RajmohanSriram/Nano-PPS/PPS_Trigger_mod.csv

Reference | Qty | Value | DNP | Exclude from BOM | Exclude from Board | Exclude from Simulation | Exclude from Position Files | Footprint | Datasheet
C1 | 1 | 100n |  |  |  |  | ${EXCLUDE_FROM_POS_FILES} | Capacitor_SMD:C_0805_2012Metric_Pad1.18x1.45mm_HandSolder
C2,C7,C17,C25 | 4 | 10u |  |  |  |  | ${EXCLUDE_FROM_POS_FILES} | Capacitor_SMD:C_0805_2012Metric_Pad1.18x1.45mm_HandSolder
C3 | 1 | 1u |  |  |  |  | ${EXCLUDE_FROM_POS_FILES} | Capacitor_SMD:C_0805_2012Metric_Pad1.18x1.45mm_HandSolder
C4,C6,C8,C11,C14,C15,C16,C18,C19,C20,C21,C22,C23,C24,C26,C27,C28 | 17 | 100n |  |  |  |  | ${EXCLUDE_FROM_POS_FILES} | Capacitor_SMD:C_0603_1608Metric_Pad1.08x0.95mm_HandSolder
C5 | 1 | 1u |  |  |  |  | ${EXCLUDE_FROM_POS_FILES} | Capacitor_SMD:C_0603_1608Metric_Pad1.08x0.95mm_HandSolder
C9,C10 | 2 | 22u |  |  |  |  | ${EXCLUDE_FROM_POS_FILES} | Capacitor_SMD:C_1210_3225Metric_Pad1.33x2.70mm_HandSolder
C12,C13 | 2 | 22p |  |  |  |  | ${EXCLUDE_FROM_POS_FILES} | Capacitor_SMD:C_0603_1608Metric_Pad1.08x0.95mm_HandSolder
D1,D2 | 2 | SMBJ24CA |  |  |  |  | ${EXCLUDE_FROM_POS_FILES} | SMBJ24CA:DIOM4336X265N
D3,D4 | 2 | LED |  |  |  |  | ${EXCLUDE_FROM_POS_FILES} | LED_SMD:LED_0603_1608Metric_Pad1.05x0.95mm_HandSolder
J1,J3 | 2 | Screw_Terminal_01x02 |  |  |  |  | ${EXCLUDE_FROM_POS_FILES} | TerminalBlock:TerminalBlock_MaiXu_MX126-5.0-02P_1x02_P5.00mm
J2 | 1 | USB4105-GF-A-120 |  |  |  |  | ${EXCLUDE_FROM_POS_FILES} | USB4105-GF-A-120:GCT_USB4105-GF-A-120
J4 | 1 | I2C_OLED |  |  |  |  | ${EXCLUDE_FROM_POS_FILES} | Connector_PinHeader_2.54mm:PinHeader_1x04_P2.54mm_Vertical
J5 | 1 | ICSP |  |  |  |  | ${EXCLUDE_FROM_POS_FILES} | Connector_PinSocket_2.54mm:PinSocket_2x03_P2.54mm_Vertical
L1 | 1 | 4u7 |  |  |  |  | ${EXCLUDE_FROM_POS_FILES} | Inductor_SMD:L_APV_ANR6045
Q1 | 1 | AO3400A |  |  |  |  | ${EXCLUDE_FROM_POS_FILES} | Package_TO_SOT_SMD:SOT-23 | http://www.aosmd.com/pdfs/datasheet/AO3400A.pdf
R1 | 1 | 5m |  |  |  |  | ${EXCLUDE_FROM_POS_FILES} | Resistor_SMD:R_0603_1608Metric_Pad0.98x0.95mm_HandSolder
R2 | 1 | 6.2K |  |  |  |  | ${EXCLUDE_FROM_POS_FILES} | Resistor_SMD:R_0603_1608Metric_Pad0.98x0.95mm_HandSolder
R3,R4 | 2 | 5.1K |  |  |  |  | ${EXCLUDE_FROM_POS_FILES} | Resistor_SMD:R_0603_1608Metric_Pad0.98x0.95mm_HandSolder
R5,R8 | 2 | 10K |  |  |  |  | ${EXCLUDE_FROM_POS_FILES} | Resistor_SMD:R_0603_1608Metric_Pad0.98x0.95mm_HandSolder
R6,R7 | 2 | 4.7K |  |  |  |  | ${EXCLUDE_FROM_POS_FILES} | Resistor_SMD:R_0603_1608Metric_Pad0.98x0.95mm_HandSolder
R9,R10 | 2 | 1K |  |  |  |  | ${EXCLUDE_FROM_POS_FILES} | Resistor_SMD:R_0603_1608Metric_Pad0.98x0.95mm_HandSolder
SW1 | 1 | V_DEC |  |  |  |  | ${EXCLUDE_FROM_POS_FILES} | Button_Switch_THT:SW_PUSH_6mm_H5mm
SW2 | 1 | I_DEC |  |  |  |  | ${EXCLUDE_FROM_POS_FILES} | Button_Switch_THT:SW_PUSH_6mm_H5mm
SW3 | 1 | OUTPUT_CTRL |  |  |  |  | ${EXCLUDE_FROM_POS_FILES} | Button_Switch_THT:SW_PUSH_6mm_H5mm
SW4 | 1 | V_INC |  |  |  |  | ${EXCLUDE_FROM_POS_FILES} | Button_Switch_THT:SW_PUSH_6mm_H5mm
SW5 | 1 | I_INC |  |  |  |  | ${EXCLUDE_FROM_POS_FILES} | Button_Switch_THT:SW_PUSH_6mm_H5mm
SW6 | 1 | MCU_~{RST} |  |  |  |  | ${EXCLUDE_FROM_POS_FILES} | Button_Switch_THT:SW_PUSH_6mm_H5mm
TH1 | 1 | Thermistor_NTC |  |  |  |  | ${EXCLUDE_FROM_POS_FILES} | Resistor_THT:R_Axial_DIN0204_L3.6mm_D1.6mm_P7.62mm_Horizontal
TP1,TP2,TP3,TP4,TP5,TP6,TP7,TP8,TP9,TP10,TP11 | 11 | TestPoint |  |  |  |  | ${EXCLUDE_FROM_POS_FILES} | TestPoint:TestPoint_Pad_D1.0mm
U1 | 1 | USBLC6-2SC6 |  |  |  |  | ${EXCLUDE_FROM_POS_FILES} | Package_TO_SOT_SMD:SOT-23-6 | https://www.st.com/resource/en/datasheet/usblc6-2.pdf
U2 | 1 | AP33772SDKZ-xx-FA02 |  |  |  |  | ${EXCLUDE_FROM_POS_FILES} | Package_DFN_QFN:Texas_RTW_WQFN-24-1EP_4x4mm_P0.5mm_EP2.7x2.7mm | https://www.diodes.com/datasheet/download/AP33772S.pdf
U3 | 1 | AP63205WU |  |  |  |  | ${EXCLUDE_FROM_POS_FILES} | Package_TO_SOT_SMD:TSOT-23-6 | https://www.diodes.com/assets/Datasheets/AP63200-AP63201-AP63203-AP63205.pdf
U4 | 1 | CH340C |  |  |  |  | ${EXCLUDE_FROM_POS_FILES} | Package_SO:SOIC-16_3.9x9.9mm_P1.27mm | https://datasheet.lcsc.com/szlcsc/Jiangsu-Qin-Heng-CH340C_C84681.pdf
U5 | 1 | ATmega328P-A |  |  |  |  | ${EXCLUDE_FROM_POS_FILES} | Package_QFP:TQFP-32_7x7mm_P0.8mm | http://ww1.microchip.com/downloads/en/DeviceDoc/ATmega328_P%20AVR%20MCU%20with%20picoPower%20Technology%20Data%20Sheet%2040001984A.pdf
Y1 | 1 | 16MHz |  |  |  |  | ${EXCLUDE_FROM_POS_FILES} | Crystal:Crystal_SMD_HC49-SD
