RajmohanSriram/Nano-PPS/FIN_SCHE.pdf

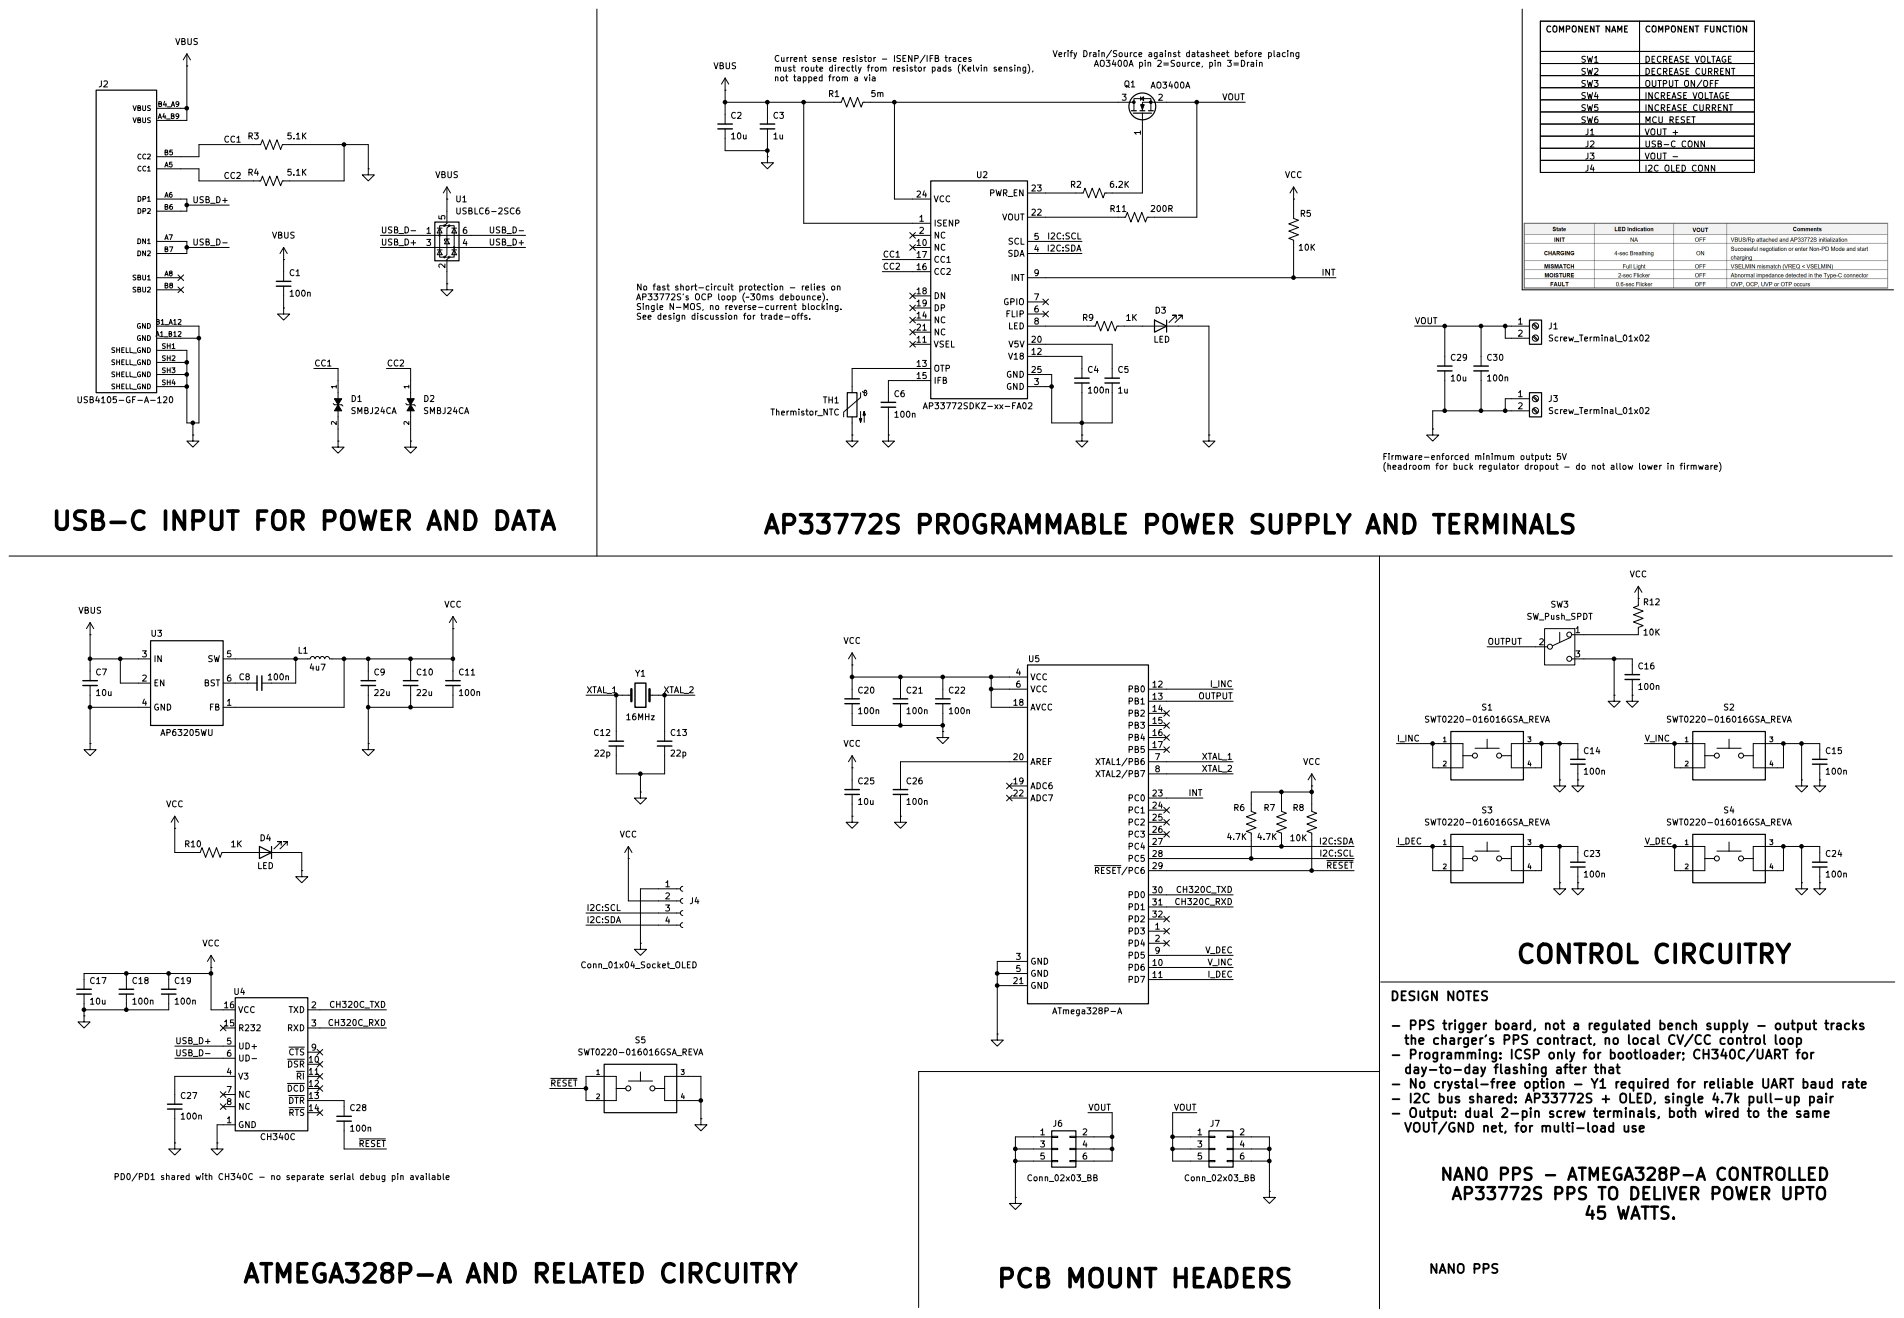
[picture p10: page 1]
