RajmohanSriram/Nano-PPS/PPS_Trigger_mod.kicad_pcb

## KiCad design PPS_Trigger_mod.kicad_pcb (2026-10-08)

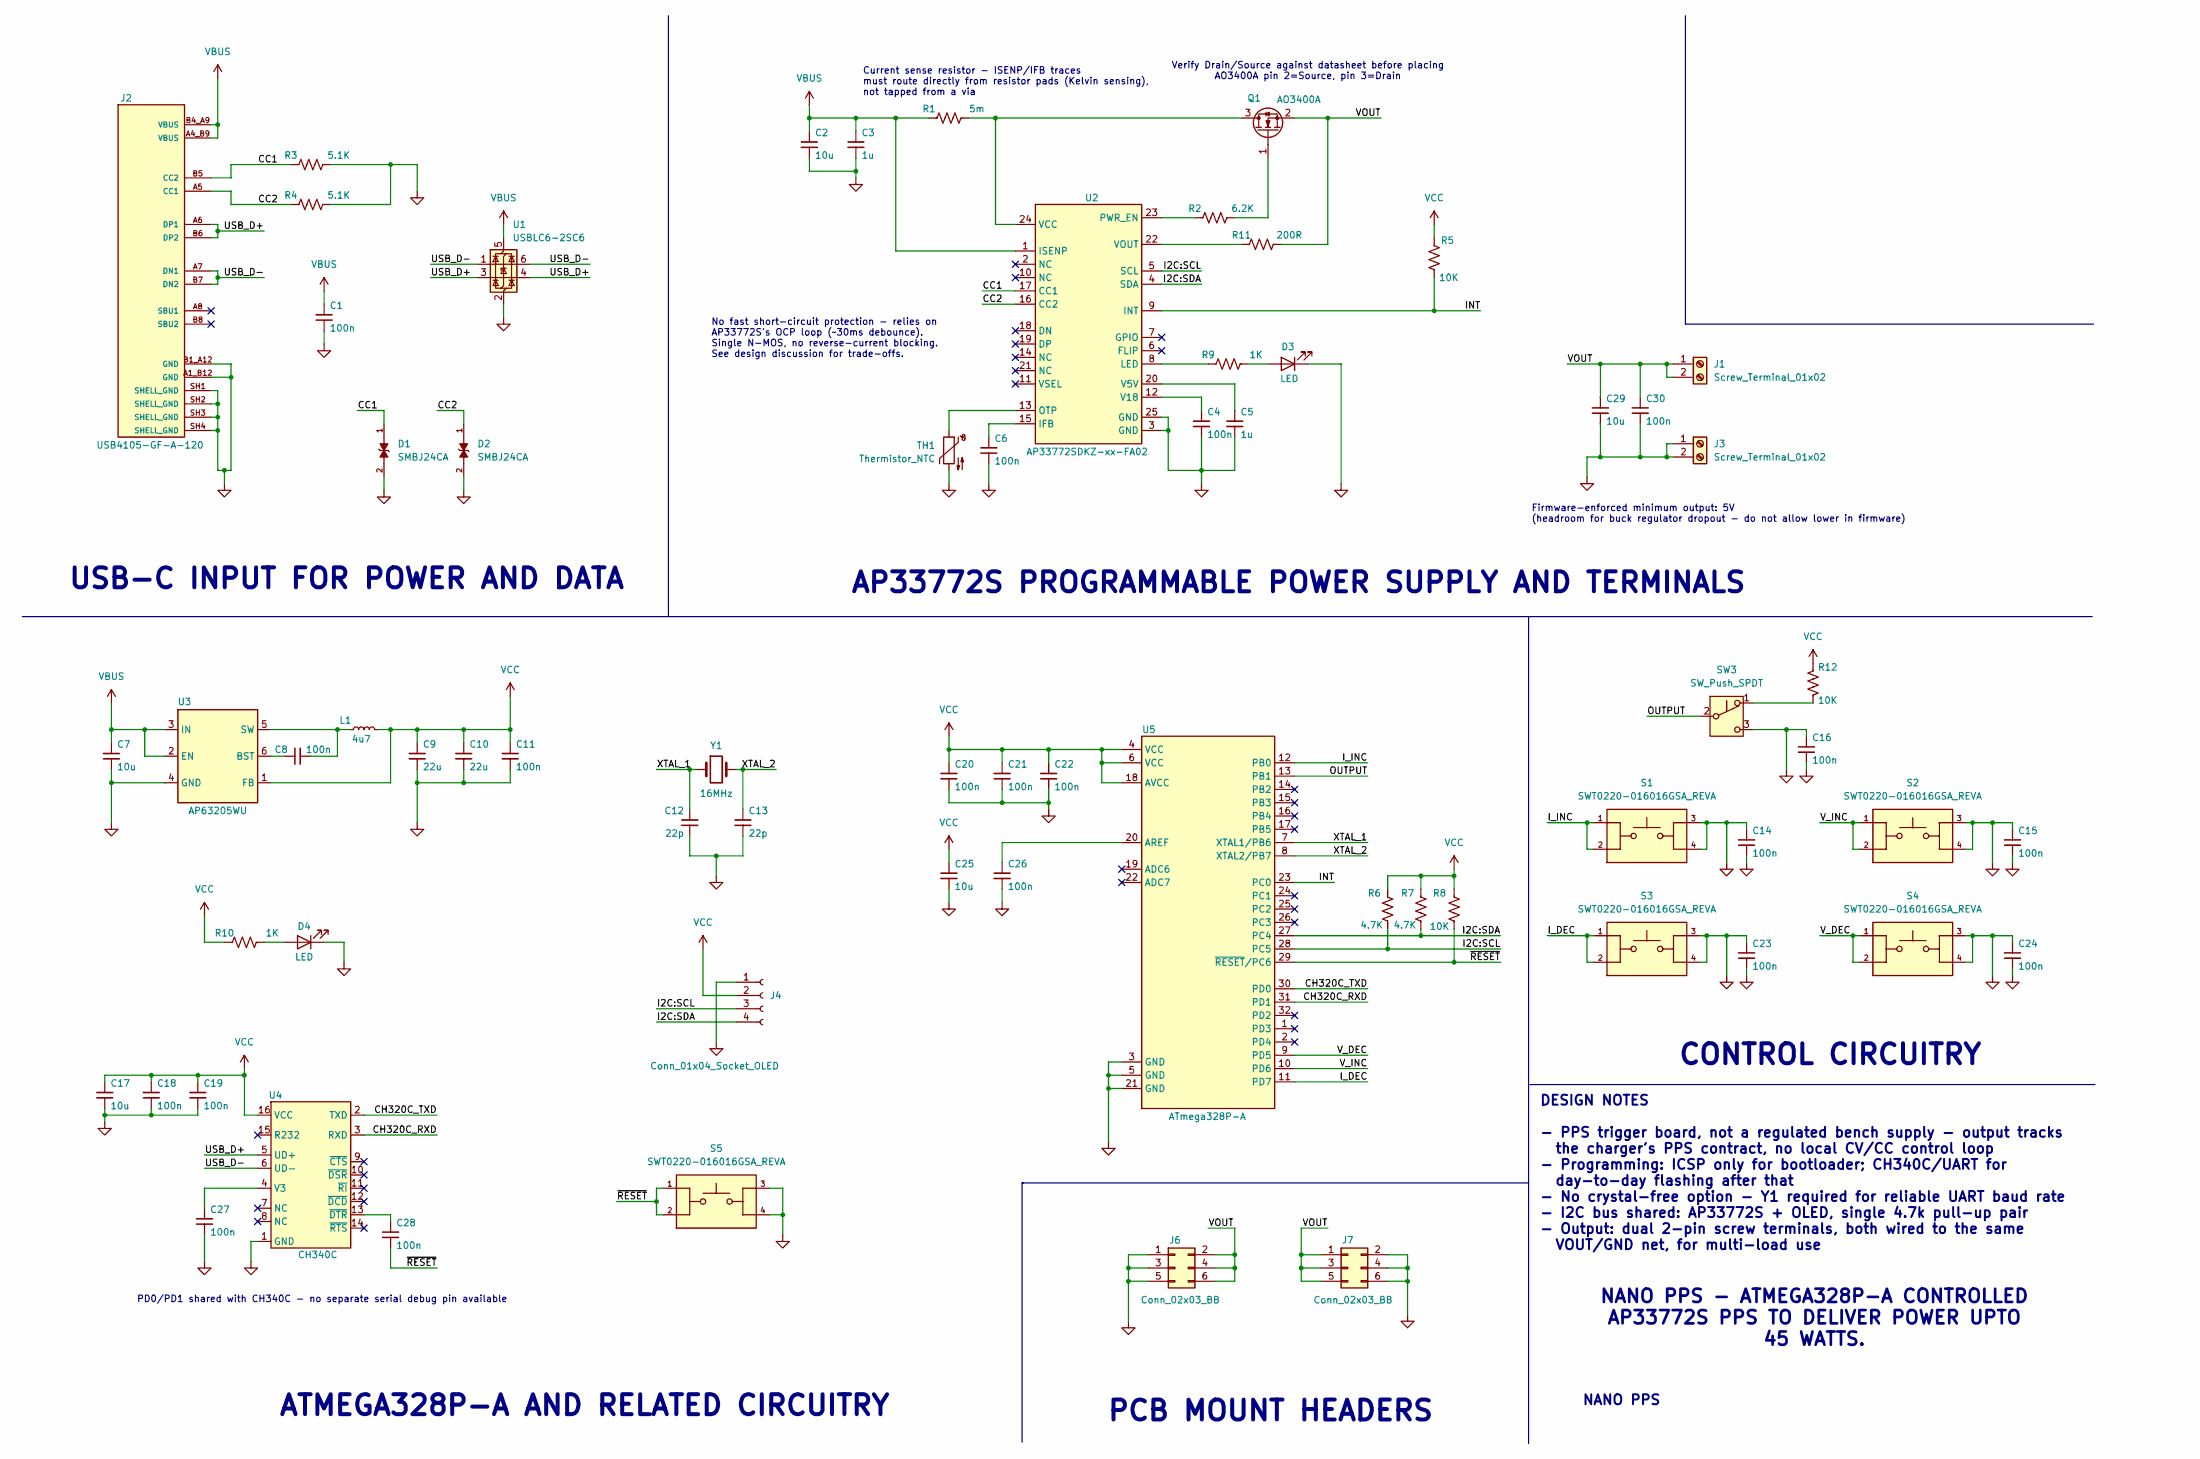
[picture p11: schematic PPS_Trigger_mod.kicad_sch]

Parts:
C1, C30: 100n; C_0805_2012Metric_Pad1.18x1.45mm_HandSolder
C2, C7, C17, C25, C29: 10u; C_0805_2012Metric_Pad1.18x1.45mm_HandSolder
C3: 1u; C_0805_2012Metric_Pad1.18x1.45mm_HandSolder
C4, C6, C8, C11, C14, C15, C16, C18, C19, C20, C21, C22, C23, C24, C26, C27, C28: 100n; C_0603_1608Metric_Pad1.08x0.95mm_HandSolder
C5: 1u; C_0603_1608Metric_Pad1.08x0.95mm_HandSolder
C9, C10: 22u; C_1210_3225Metric_Pad1.33x2.70mm_HandSolder
C12, C13: 22p; C_0603_1608Metric_Pad1.08x0.95mm_HandSolder
D1, D2: SMBJ24CA; DIOM4336X265N; PARTREV I2102
D3, D4: LED; LED_0603_1608Metric_Pad1.05x0.95mm_HandSolder
J1, J3: Screw_Terminal_01x02; TerminalBlock_MaiXu_MX126-5.0-02P_1x02_P5.00mm
J2: USB4105-GF-A-120; GCT_USB4105-GF-A-120; PARTREV B3
J4: Conn_01x04_Socket_OLED; PinSocket_1x04_P2.54mm_Vertical
J6, J7: Conn_02x03_BB; PinHeader_2x03_P2.54mm_Vertical
L1: 4u7; L_APV_ANR6045
Q1: AO3400A; SOT-23
R1: 5m; R_1206_3216Metric_Pad1.30x1.75mm_HandSolder
R2: 6.2K; R_0603_1608Metric_Pad0.98x0.95mm_HandSolder
R3, R4: 5.1K; R_0603_1608Metric_Pad0.98x0.95mm_HandSolder
R5, R8, R12: 10K; R_0603_1608Metric_Pad0.98x0.95mm_HandSolder
R6, R7: 4.7K; R_0603_1608Metric_Pad0.98x0.95mm_HandSolder
R9, R10: 1K; R_0603_1608Metric_Pad0.98x0.95mm_HandSolder
R11: 200R; R_0603_1608Metric_Pad0.98x0.95mm_HandSolder
S1, S2, S3, S4, S5: SWT0220-016016GSA_REVA; SW_SWT0220-016016GSA_REVA; PARTREV A
SW3: SW_Push_SPDT; SW_Slide_SPDT_Straight_CK_OS102011MS2Q
TH1: Thermistor_NTC; R_Axial_DIN0204_L3.6mm_D1.6mm_P7.62mm_Horizontal
U1: USBLC6-2SC6; SOT-23-6
U2: AP33772SDKZ-xx-FA02; Texas_RTW_WQFN-24-1EP_4x4mm_P0.5mm_EP2.7x2.7mm
U3: AP63205WU; TSOT-23-6
U4: CH340C; SOIC-16_3.9x9.9mm_P1.27mm
U5: ATmega328P-A; TQFP-32_7x7mm_P0.8mm
Y1: 16MHz; Crystal_SMD_HC49-SD

Connections:
/CC1: D1.1, J2.B5 (CC2), R3.1, U2.17 (CC1)
/CC2: D2.1, J2.A5 (CC1), R4.1, U2.16 (CC2)
/CH320C_RXD: U4.3 (RXD), U5.31 (PD1)
/CH320C_TXD: U4.2 (TXD), U5.30 (PD0)
/I2C:SCL: J4.3, R6.1, U2.5 (SCL), U5.28 (PC5)
/I2C:SDA: J4.4, R7.1, U2.4 (SDA), U5.27 (PC4)
/INT: R5.1, U2.9 (INT), U5.23 (PC0)
/I_DEC: S3.1, S3.2, U5.11 (PD7)
/I_INC: S1.1, S1.2, U5.12 (PB0)
/OUTPUT: SW3.2 (B), U5.13 (PB1)
/USB_D+: J2.A6 (DP1), J2.B6 (DP2), U1.3 (I/O2), U1.4 (I/O2), U4.5 (UD+)
/USB_D-: J2.A7 (DN1), J2.B7 (DN2), U1.1 (I/O1), U1.6 (I/O1), U4.6 (UD-)
/VOUT: C29.1, C30.1, J1.1, J1.2, J6.2, J6.4, J6.6, J7.1, J7.3, J7.5, Q1.2 (S), R11.2
/V_DEC: S4.1, S4.2, U5.9 (PD5)
/V_INC: S2.1, S2.2, U5.10 (PD6)
/XTAL_1: C12.1, U5.7 (XTAL1/PB6), Y1.1
/XTAL_2: C13.1, U5.8 (XTAL2/PB7), Y1.2
/~RESET: C28.2, R8.1, S5.1, S5.2, U5.29 (~RESET/PC6)
GND: C1.2, C2.2, C3.2, C4.2, C5.2, C6.2, C7.2, C9.2, C10.2, C11.2, C12.2, C13.2, C14.1, C14.2, C15.1, C15.2, C16.1, C16.2, C17.2, C18.2, C19.2, C20.2, C21.2, C22.2, C23.1, C23.2, C24.1, C24.2, C25.2, C26.2, C27.2, C29.2, C30.2, D1.2, D2.2, D3.1 (K), D4.1 (K), J2.A1_B12 (GND), J2.B1_A12 (GND), J2.SH1 (SHELL_GND), J2.SH2 (SHELL_GND), J2.SH3 (SHELL_GND), J2.SH4 (SHELL_GND), J3.1, J3.2, J4.1, J6.1, J6.3, J6.5, J7.2, J7.4, J7.6, R3.2, R4.2, S1.3, S1.4, S2.3, S2.4, S3.3, S3.4, S4.3, S4.4, S5.3, S5.4, SW3.3 (C), TH1.2, U1.2 (GND), U2.3 (GND), U2.25 (GND), U3.4 (GND), U4.1 (GND), U5.3 (GND), U5.5 (GND), U5.21 (GND)
unnamed: D3.2 (A), R9.2
unnamed: D4.2 (A), R10.2
unnamed: Q1.3 (D), R1.2, U2.24 (VCC)
unnamed: Q1.1 (G), R2.2
unnamed: R12.1, SW3.1 (A)
unnamed: C6.1, U2.15 (IFB)
unnamed: R9.1, U2.8 (LED)
unnamed: TH1.1, U2.13 (OTP)
unnamed: R2.1, U2.23 (PWR_EN)
unnamed: C5.1, U2.20 (V5V)
unnamed: C4.1, U2.12 (V18)
unnamed: R11.1, U2.22 (VOUT)
unnamed: C8.1, U3.6 (BST)
unnamed: C8.2, L1.1, U3.5 (SW)
unnamed: C27.1, U4.4 (V3)
unnamed: C28.1, U4.13 (~DTR)
unnamed: C26.1, U5.20 (AREF)
VBUS: C1.1, C2.1, C3.1, C7.1, J2.A4_B9 (VBUS), J2.B4_A9 (VBUS), R1.1, U1.5 (VBUS), U2.1 (ISENP), U3.2 (EN), U3.3 (IN)
VCC: C9.1, C10.1, C11.1, C17.1, C18.1, C19.1, C20.1, C21.1, C22.1, C25.1, J4.2, L1.2, R5.2, R6.2, R7.2, R8.2, R10.1, R12.2, U3.1 (FB), U4.16 (VCC), U5.4 (VCC), U5.6 (VCC), U5.18 (AVCC)

Notes on the sheet:
CONTROL CIRCUITRY
Verify Drain/Source against datasheet before placing AO3400A pin 2=Source, pin 3=Drain
PCB MOUNT HEADERS
PD0/PD1 shared with CH340C - no separate serial debug pin available
NANO PPS
AP33772S PROGRAMMABLE POWER SUPPLY AND TERMINALS
USB-C INPUT FOR POWER AND DATA
DESIGN NOTES - PPS trigger board, not a regulated bench supply - output tracks the charger's PPS contract, no local CV/CC control loop - Programming: ICSP only for bootloader; CH340C/UART for day-to-day flashing after that - No crystal-free option - Y1 required for reliable UART baud rate - I2C bus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
ATMEGA328P-A AND RELATED CIRCUITRY
NANO PPS - ATMEGA328P-A CONTROLLED AP33772S PPS TO DELIVER POWER UPTO 45 WATTS.
No fast short-circuit protection - relies on AP33772S's OCP loop (~30ms debounce). Single N-MOS, no reverse-current blocking. See design discussion for trade-offs.
Firmware-enforced minimum output: 5V (headroom for buck regulator dropout - do not allow lower in firmware)
Current sense resistor - ISENP/IFB traces must route directly from resistor pads (Kelvin sensing), not tapped from a via

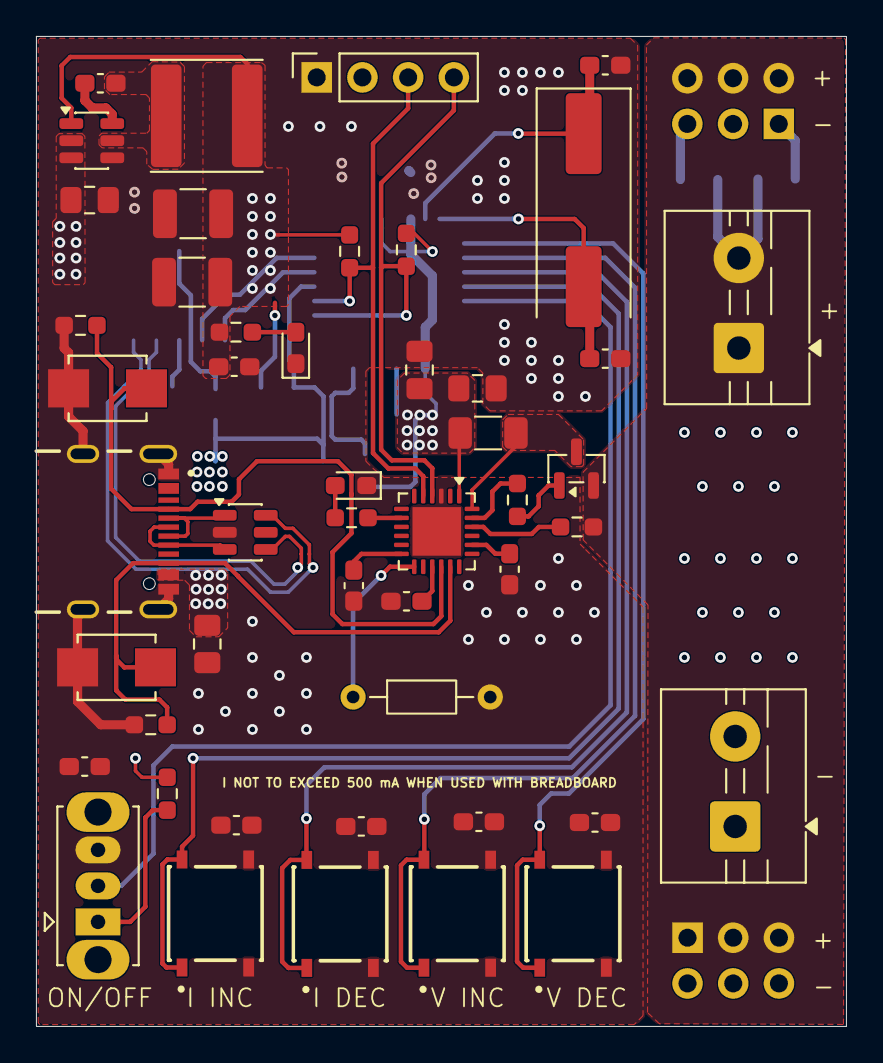
[picture p12: board PPS_Trigger_mod.kicad_pcb from above]

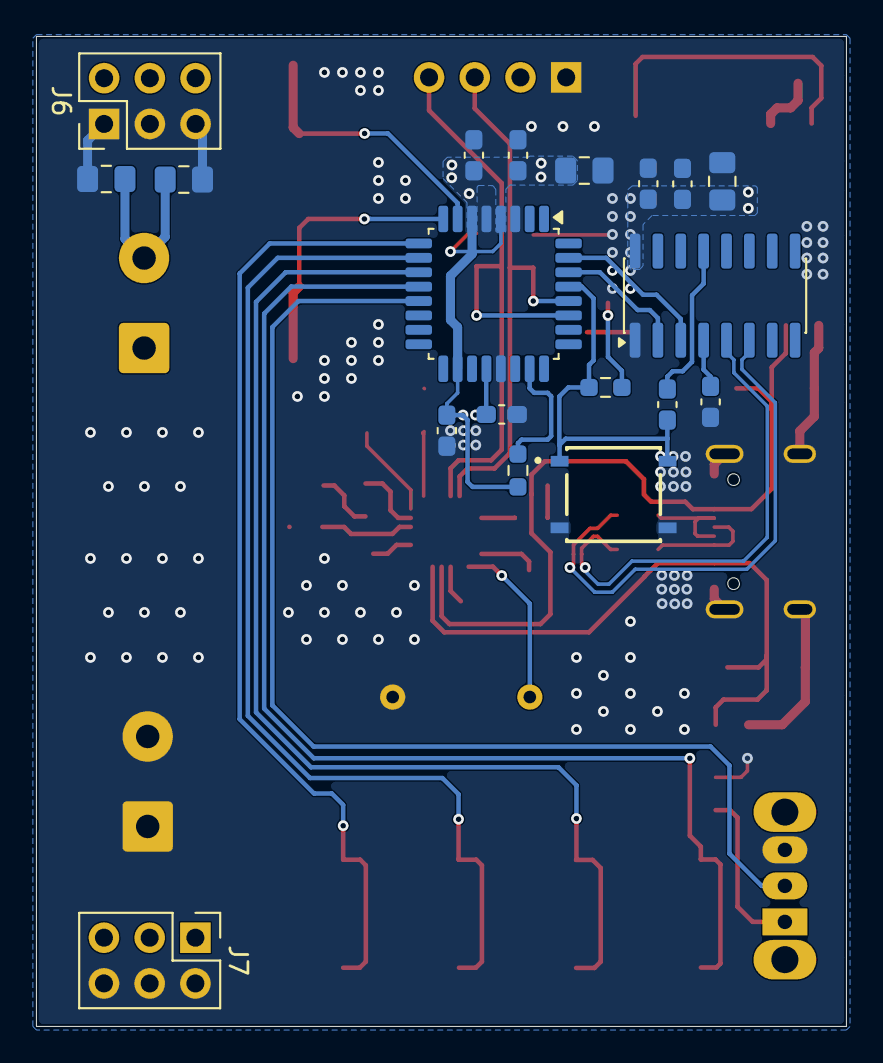
[picture p13: board PPS_Trigger_mod.kicad_pcb from below]

Board: 4 copper layers, 45.0 x 55.0 mm, 67 parts (19 on the bottom side), 38 nets.
